bigjosh/Mechanical/README.md

# Mechanical
Mechanical design files

This repo contains documentation for the mechanical components & assembly of The Public Radio.
