bigjosh/Mechanical/PR2034 Antenna.stp

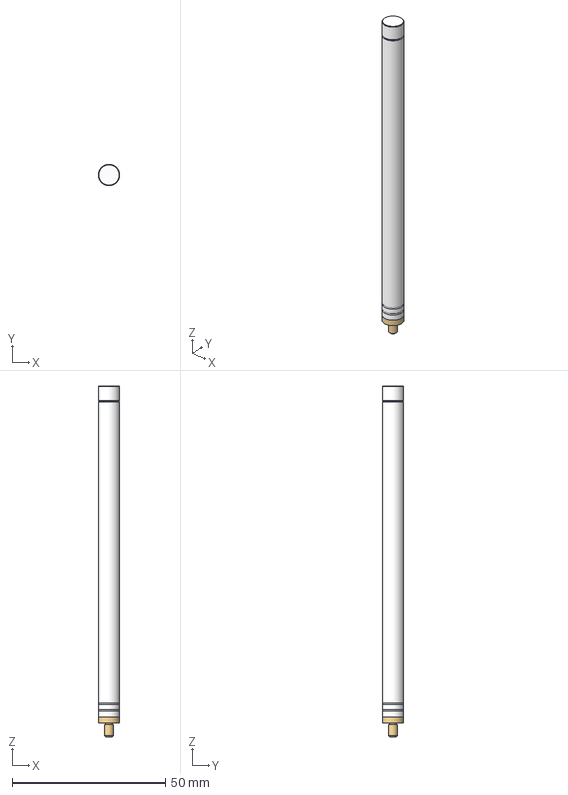
[picture p1: CAD file, 2017-05-16]
PR2034 Antenna.stp
6.99 x 7.00 x 114.5 mm
PR1029 Male thread antenna base
PR1030 Antenna tube 1
PR1031 Antenna tube 2
PR1032 Antenna tube 3
PR1033 Antenna tube 4
PR1034 Antenna tube 5
PR1035 Antenna tube 6
PR1036 Antenna cap
