bigjosh/Mechanical/PR2033 Ground up speaker.stp

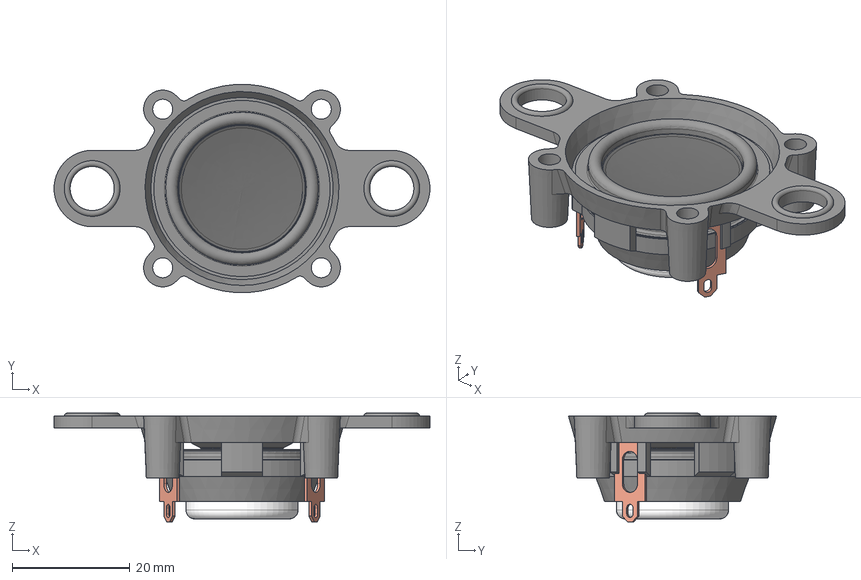
[picture p2: CAD file, 2016-03-14]
PR2033 Ground up speaker.stp
64.0 x 35.4 x 18.5 mm
PR2029 Redesigned speaker basket
YP
UT
CT
HS
FC
YQ
TB
PRT0003
PR2033 Speaker terminal x 2
