bigjosh/Mechanical/PR1014 REV H Sheet lid.stp

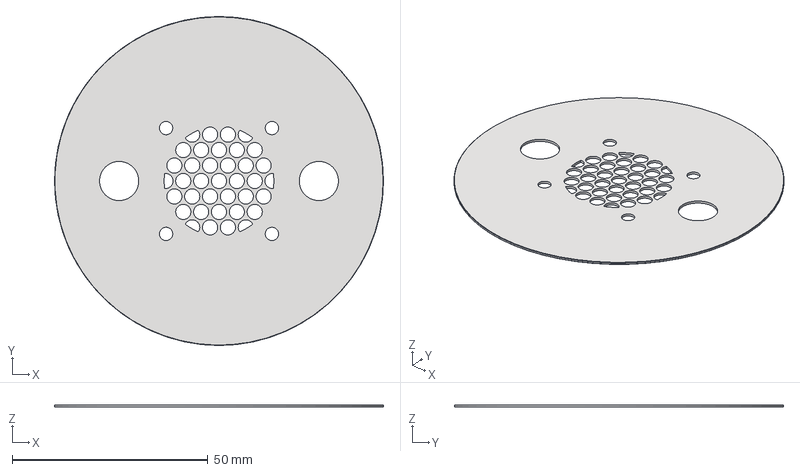
[picture p3: CAD file, 2016-03-14]
PR1014 REV H Sheet lid.stp
84.0 x 84.0 x 0.607 mm
