bigjosh/Mechanical/PR1037 Knob.stp

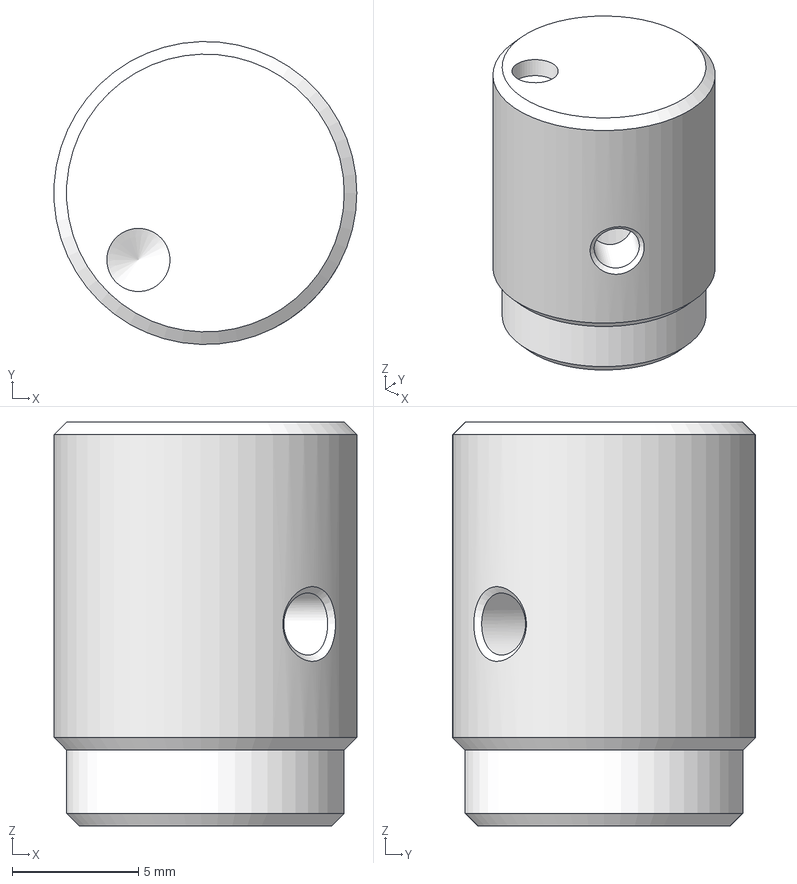
[picture p4: CAD file, 2016-03-14]
PR1037 Knob.stp
12.0 x 12.0 x 16.0 mm
