bigjosh/Mechanical/PR2034 Antenna REV A.pdf

## PART LIST

## REVISIONS

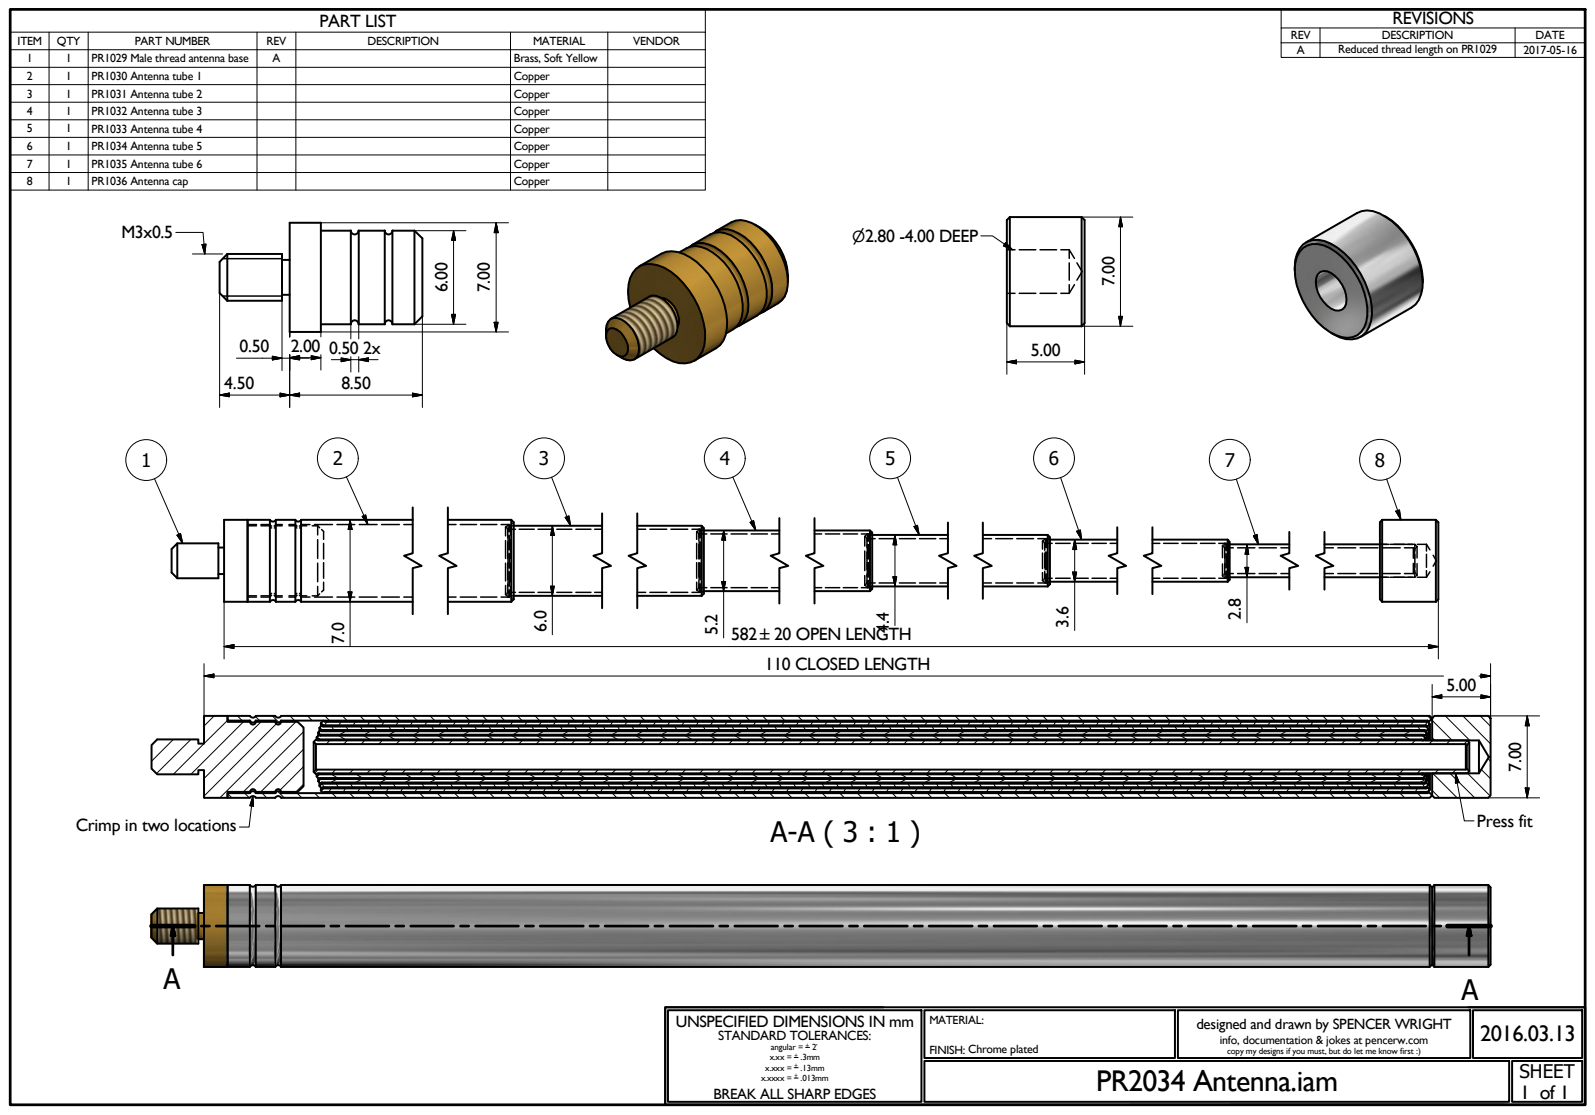
[picture p5: page 1]
ITEM; QTY; PART NUMBER; REV; DESCRIPTION; MATERIAL; VENDOR; PR1029 Male thread antenna base; Brass, Soft Yellow; PR1030 Antenna tube 1; Copper; PR1031 Antenna tube 2; PR1032 Antenna tube 3; PR1033 Antenna tube 4; PR1034 Antenna tube 5; PR1035 Antenna tube 6; PR1036 Antenna cap; PR2034 Antenna.iam; SHEET; STANDARD TOLERANCES:; angular =; x.xxx =; x.xxxx =; MATERIAL:; DATE; Reduced thread length on PR1029; 110 CLOSED LENGTH; 582 B20 OPEN LENGTH; P2.80 -4.00 DEEP; Press fit

Crimp in two locations

UNSPECIFIED DIMENSIONS IN mm

designed and drawn by SPENCER WRIGHT
info, documentation & jokes at pencerw.com
copy my designs if you must, but do let me know first :)

FINISH: Chrome plated

BREAK ALL SHARP EDGES
