bigjosh/Mechanical/PR2038 Public Radio Two REV A.pdf

## REVISIONS

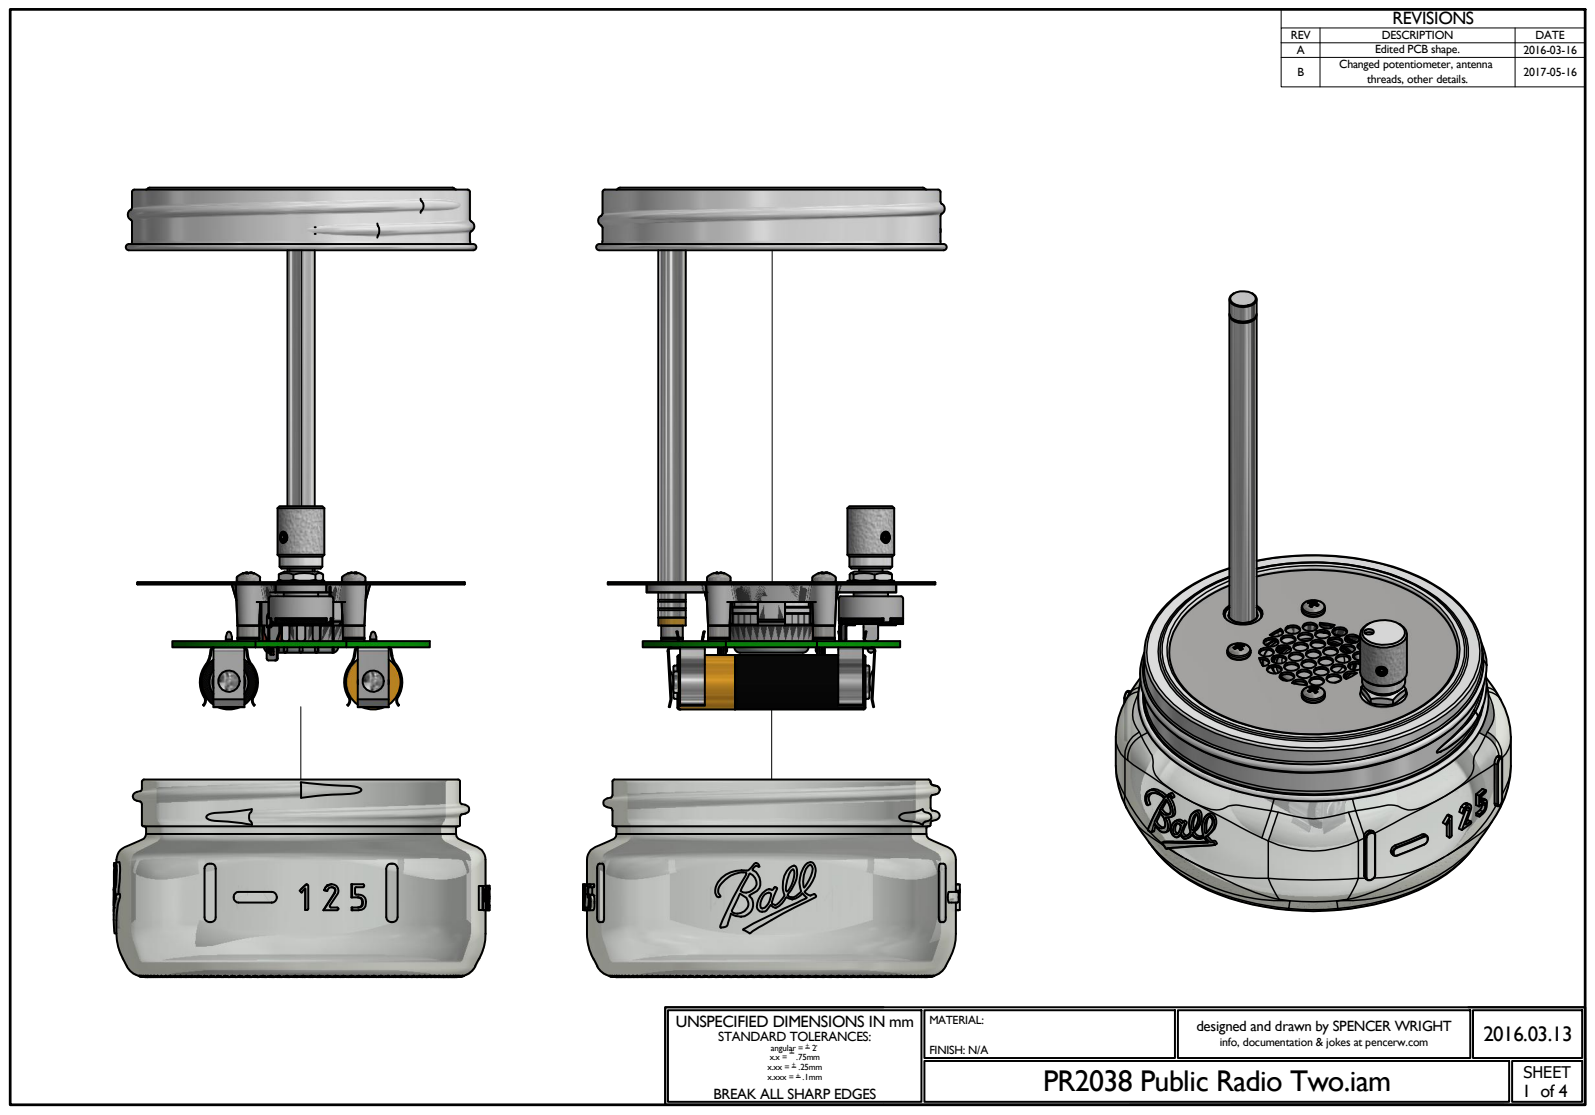
[picture p6: page 1]
SHEET; STANDARD TOLERANCES:; angular = x.x =; x.xx = x.xxx =; MATERIAL:; FINISH: N/A; REV; DESCRIPTION; DATE; Edited PCB shape.

Changed potentiometer, antenna
threads, other details.

UNSPECIFIED DIMENSIONS IN mm

designed and drawn by SPENCER WRIGHT
info, documentation & jokes at pencerw.com

PR2038 Public Radio Two.iam

BREAK ALL SHARP EDGES

## PART LIST

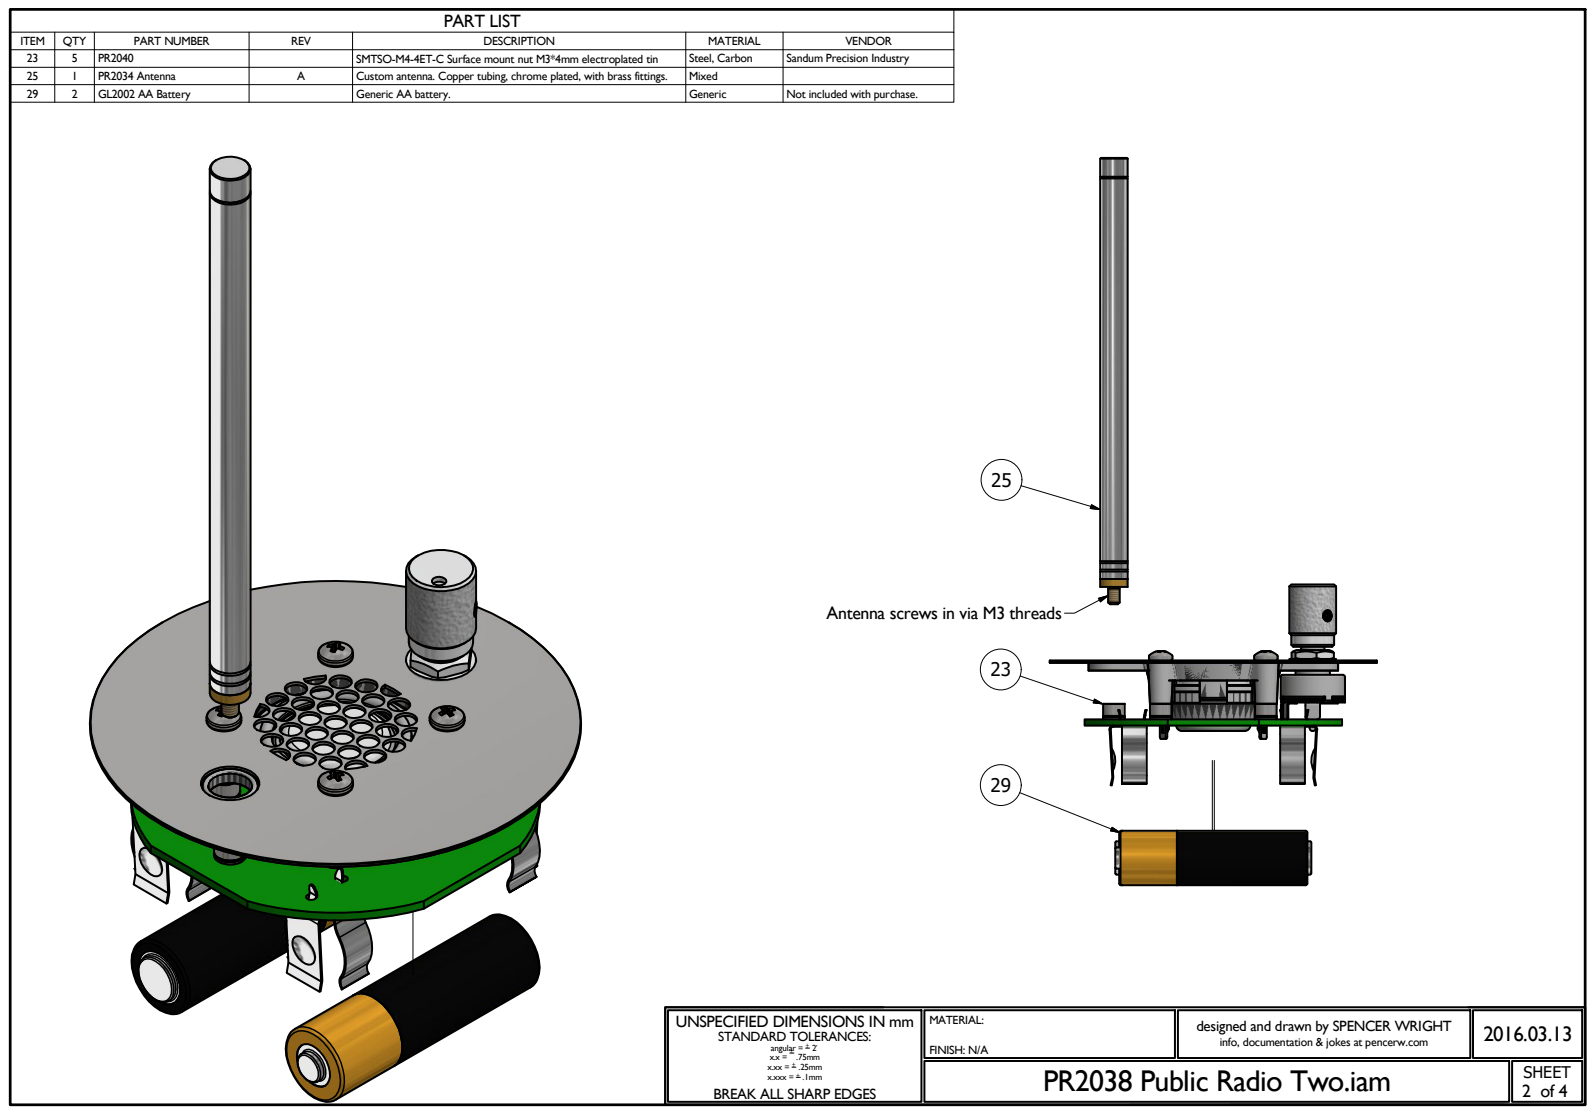
[picture p7: page 2]
ITEM; QTY; PART NUMBER; REV; DESCRIPTION; MATERIAL; VENDOR; SMTSO-M4-4ET-C Surface mount nut M3*4mm electroplated tin; Steel, Carbon; Sandum Precision Industry; PR2034 Antenna; Custom antenna. Copper tubing, chrome plated, with brass fittings.; Mixed; GL2002 AA Battery; Generic AA battery.; Generic; Not included with purchase.; STANDARD TOLERANCES:; MATERIAL:

Antenna screws in via M3 threads

UNSPECIFIED DIMENSIONS IN mm

designed and drawn by SPENCER WRIGHT

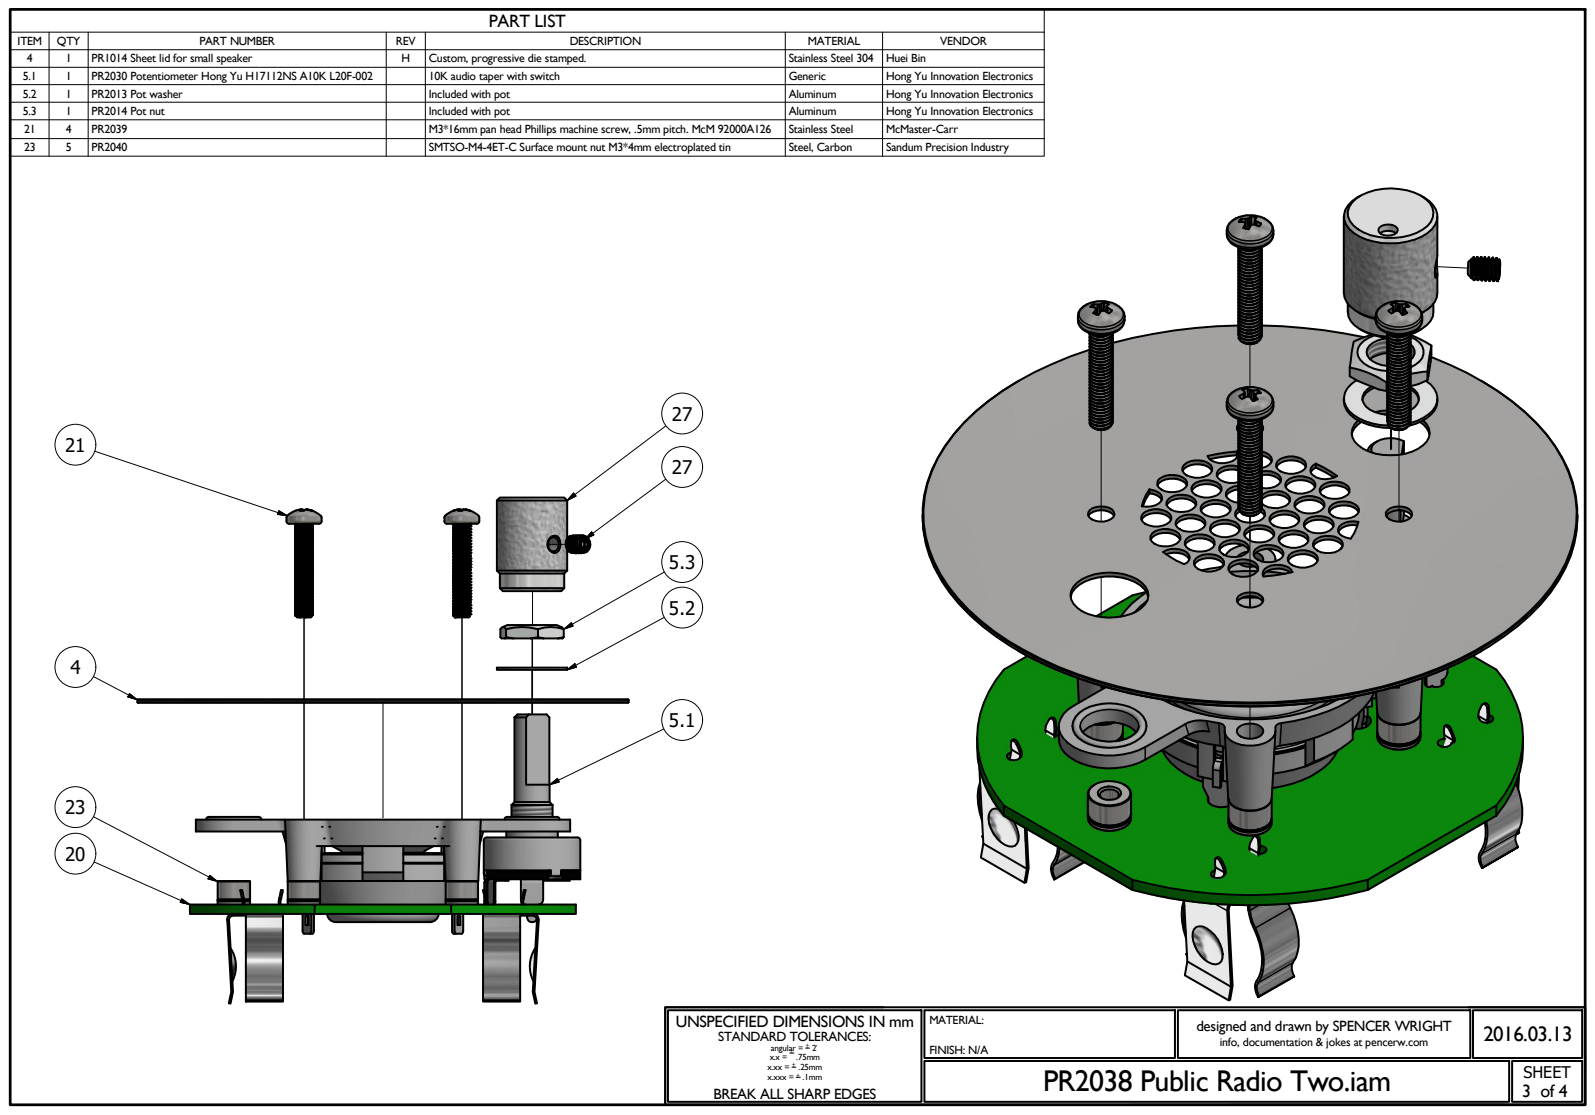
[picture p8: page 3]
PR1014 Sheet lid for small speaker; Custom, progressive die stamped.; Stainless Steel 304; Huei Bin; PR2030 Potentiometer Hong Yu H17112NS A10K L20F-002; 10K audio taper with switch; Generic; Hong Yu Innovation Electronics; PR2013 Pot washer; Included with pot; Aluminum; PR2014 Pot nut; M3*16mm pan head Phillips machine screw, .5mm pitch. McM 92000A126; Stainless Steel; McMaster-Carr; SMTSO-M4-4ET-C Surface mount nut M3*4mm electroplated tin; Steel, Carbon; Sandum Precision Industry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

UNSPECIFIED DIMENSIONS IN mm

designed and drawn by SPENCER WRIGHT

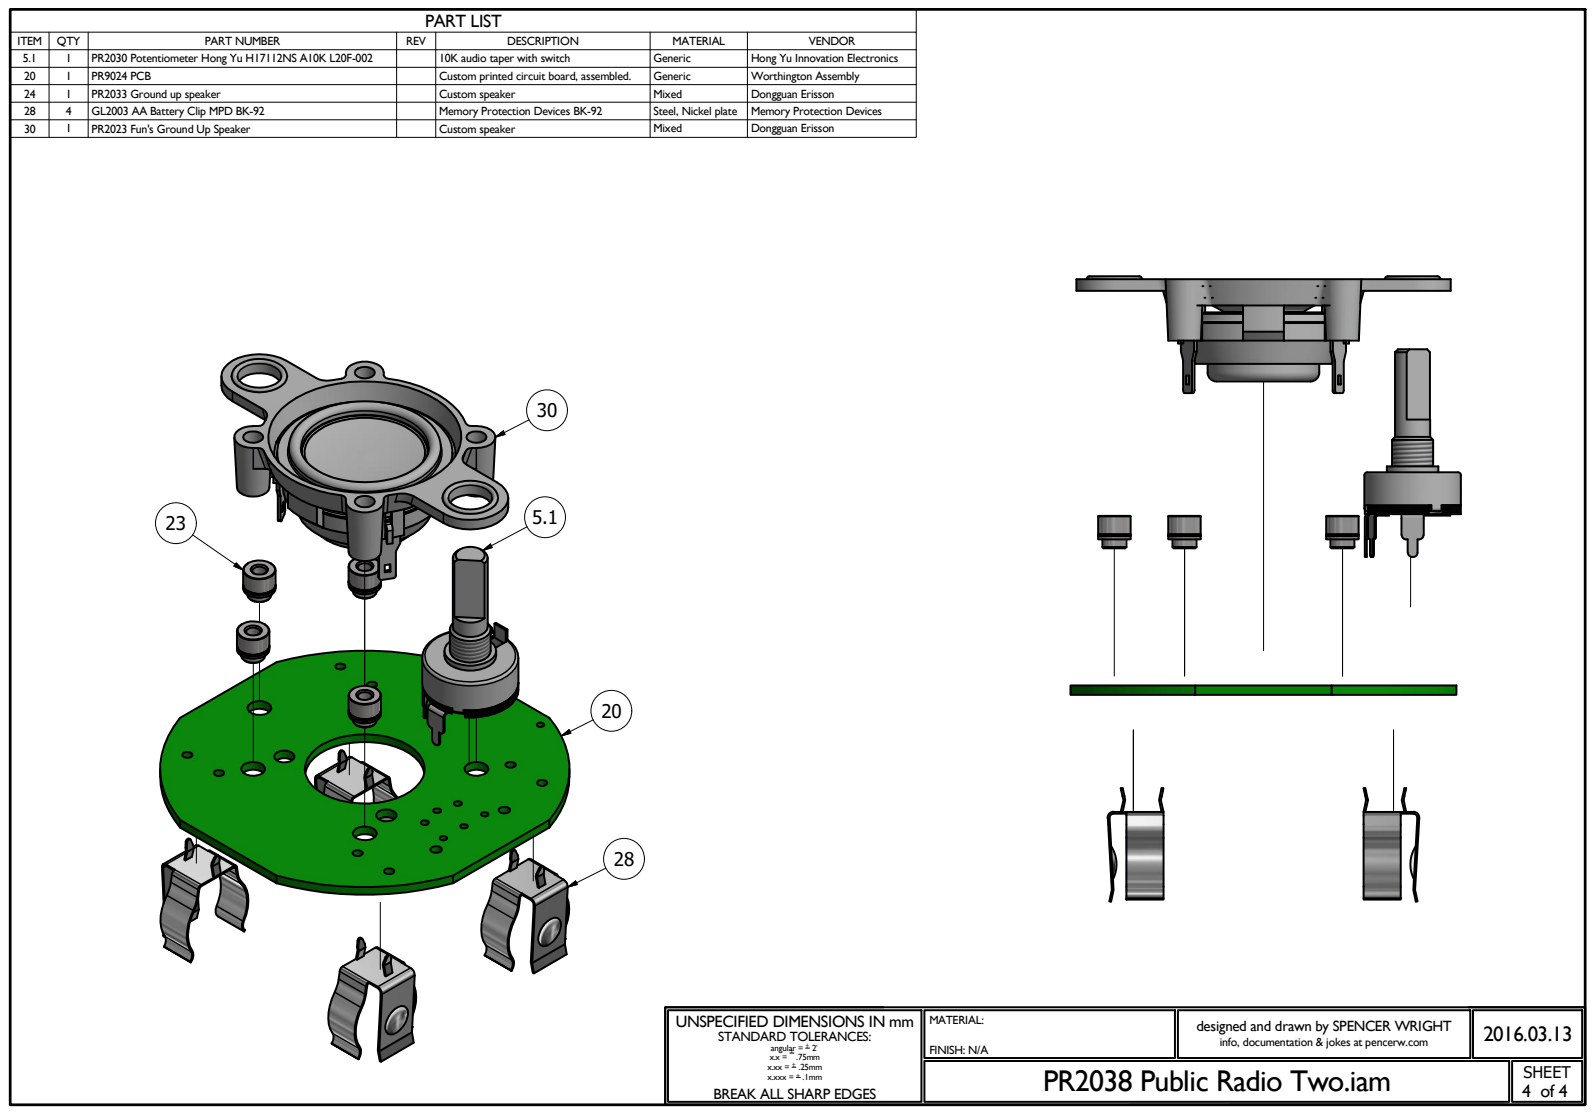
[picture p9: page 4]
PR2030 Potentiometer Hong Yu H17112NS A10K L20F-002; 10K audio taper with switch; Generic; Hong Yu Innovation Electronics; PR9024 PCB; Custom printed circuit board, assembled.; Worthington Assembly; PR2033 Ground up speaker; Custom speaker; Mixed; Dongguan Erisson; GL2003 AA Battery Clip MPD BK-92; Memory Protection Devices BK-92; Steel, Nickel plate; Memory Protection Devices; PR2023 Fun's Ground Up Speaker; STANDARD TOLERANCES:; MATERIAL:

UNSPECIFIED DIMENSIONS IN mm

designed and drawn by SPENCER WRIGHT
