bigjosh/Mechanical/PR2033 Ground up speaker.pdf

## PART LIST

## REVISIONS

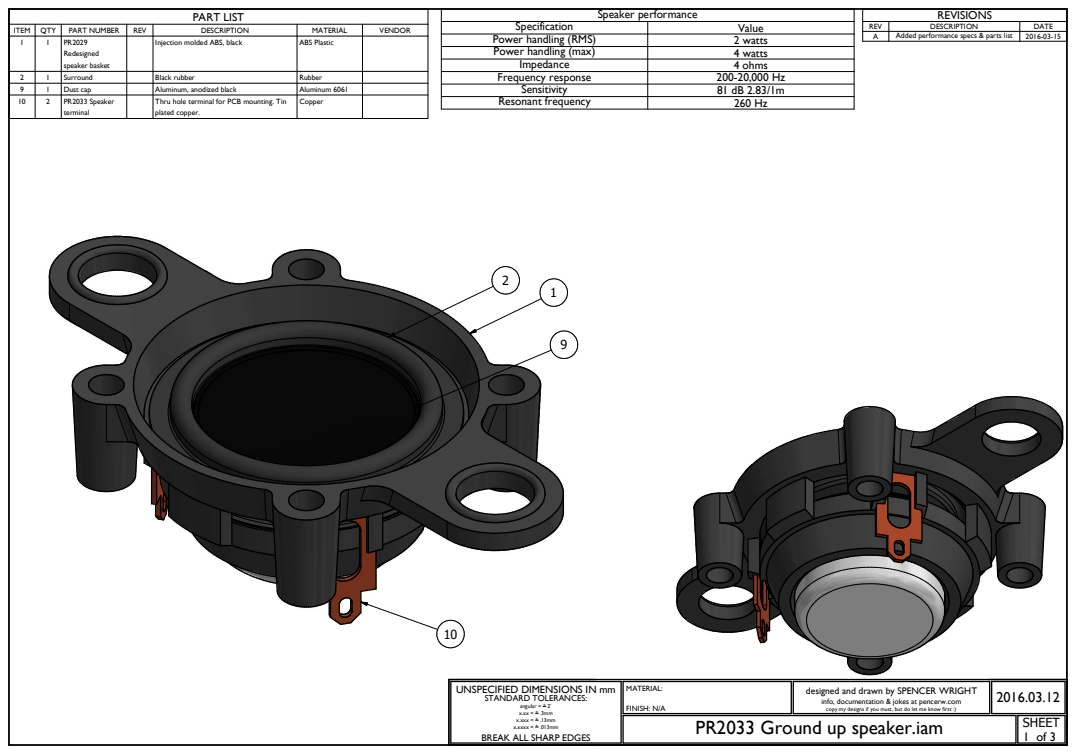
[picture p10: page 1]
2016.03.12 SHEET 1 of 3; MATERIAL: FINISH: N/A; ITEM QTY PART NUMBER REV; DESCRIPTION; MATERIAL; VENDOR; Injection molded ABS, black; ABS Plastic; Redesigned speaker basket; 1 Surround; Black rubber; Rubber; 1 Dust cap; Aluminum, anodized black; Aluminum 6061; PR2033 Speaker terminal; REV; DATE; Speaker performance; Specification; Value; Power handling (RMS); 2 watts; Power handling (max); 4 watts; Impedance; 4 ohms; Frequency response; Sensitivity; Resonant frequency

A Added performance specs & parts list 2016-03-15

Thru hole terminal for PCB mounting. Tin Copper
plated copper.

UNSPECIFIED DIMENSIONS IN mm
STANDARD TOLERANCES:
angular = ⁺- 2~
x.xxx = ⁺- .13mm
x.xxxx = ⁺- .013mm
BREAK ALL SHARP EDGES

designed and drawn by SPENCER WRIGHT
info, documentation & jokes at pencerw.com
PR2033 Ground up speaker.iam

copy my designs if you must, but do let me know first :)

# n3.4 THRU 4x 13 5. 13.5 2 5. 12.5

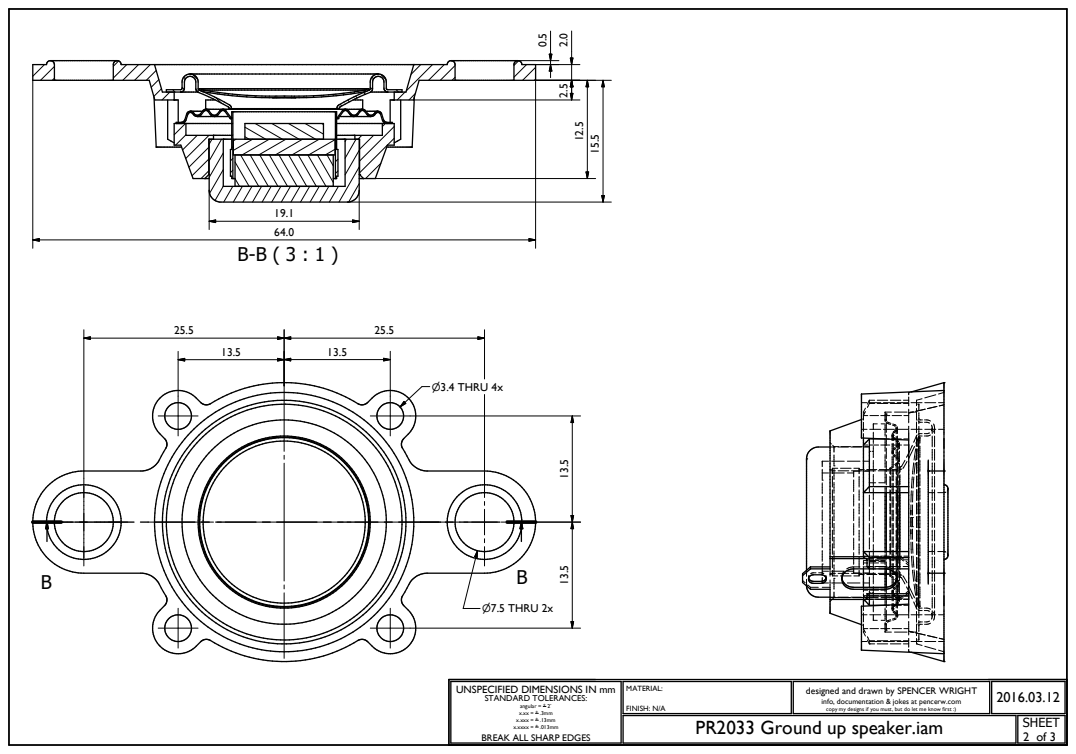
[picture p11: page 2]
MATERIAL:; n7.5 THRU 2x

UNSPECIFIED DIMENSIONS IN mm
STANDARD TOLERANCES:

designed and drawn by SPENCER WRIGHT
info, documentation & jokes at pencerw.com

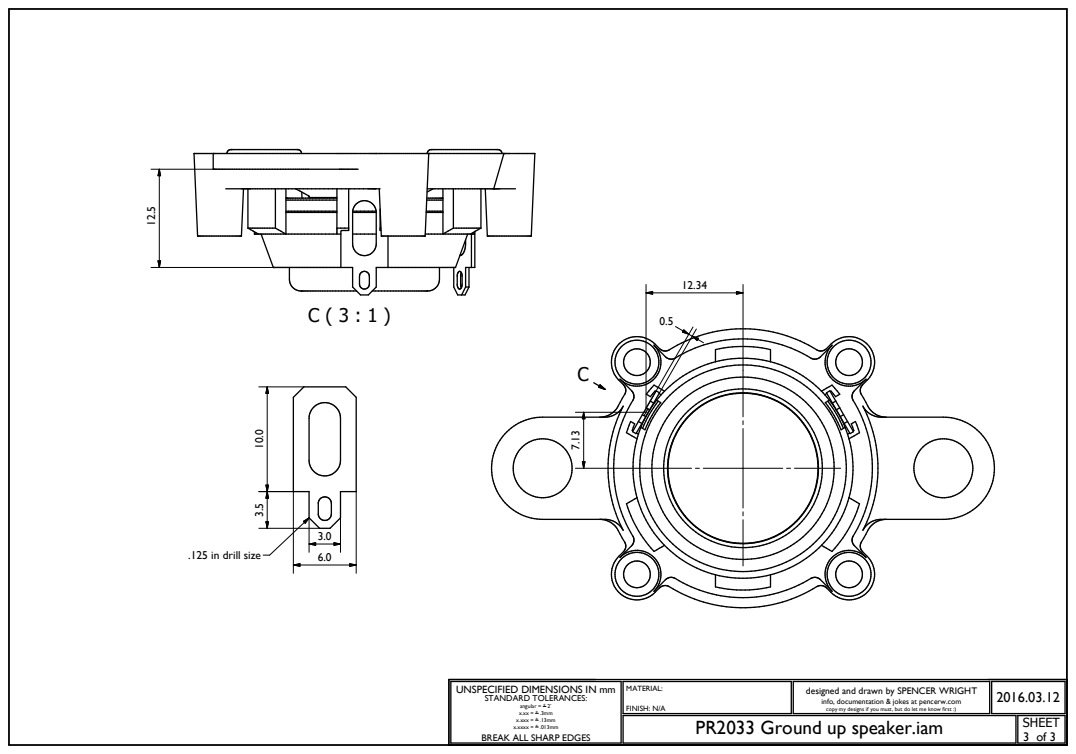
[picture p12: page 3]
.125 in drill size

UNSPECIFIED DIMENSIONS IN mm STANDARD TOLERANCES: | MATERIAL: | designed and drawn by SPENCER WRIGHT info, documentation & jokes at pencerw.com | 2016.03.12
