bigjosh/Mechanical/PR2036 Knob assy.pdf

## PART LIST

## REVISIONS

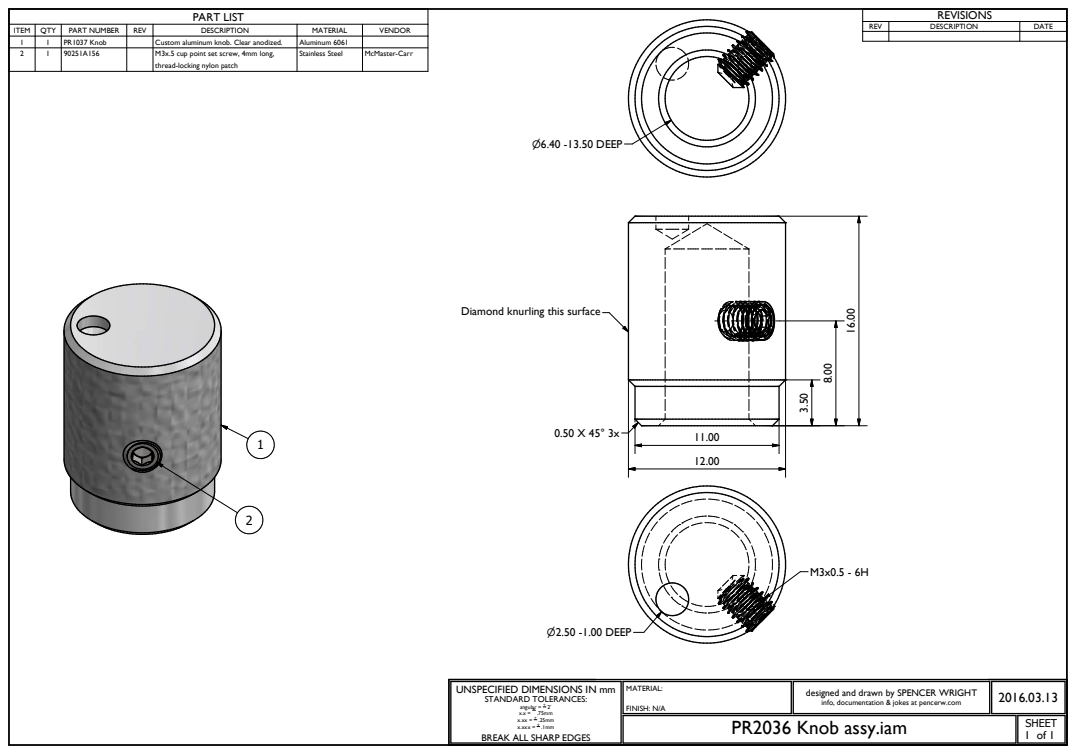
[picture p13: page 1]
2016.03.13 SHEET 1 of 1; ITEM QTY PART NUMBER REV; DESCRIPTION; MATERIAL; VENDOR; 1 PR1037 Knob; Custom aluminum knob. Clear anodized. Aluminum 6061; M3x.5 cup point set screw, 4mm long,; Stainless Steel; McMaster-Carr; REV; DATE; n2.50 -1.00 DEEP; n6.40 -13.50 DEEP

thread-locking nylon patch

Diamond knurling this surface

UNSPECIFIED DIMENSIONS IN mm
STANDARD TOLERANCES:
angular = ⁺- 2~
x.xxx = ⁺- .1mm
BREAK ALL SHARP EDGES

MATERIAL:
FINISH: N/A
PR2036 Knob assy.iam

designed and drawn by SPENCER WRIGHT
info, documentation & jokes at pencerw.com
