bigjosh/Mechanical/PR1014 REV H Sheet lid.pdf

## REVISIONS

## 24ga STOCK

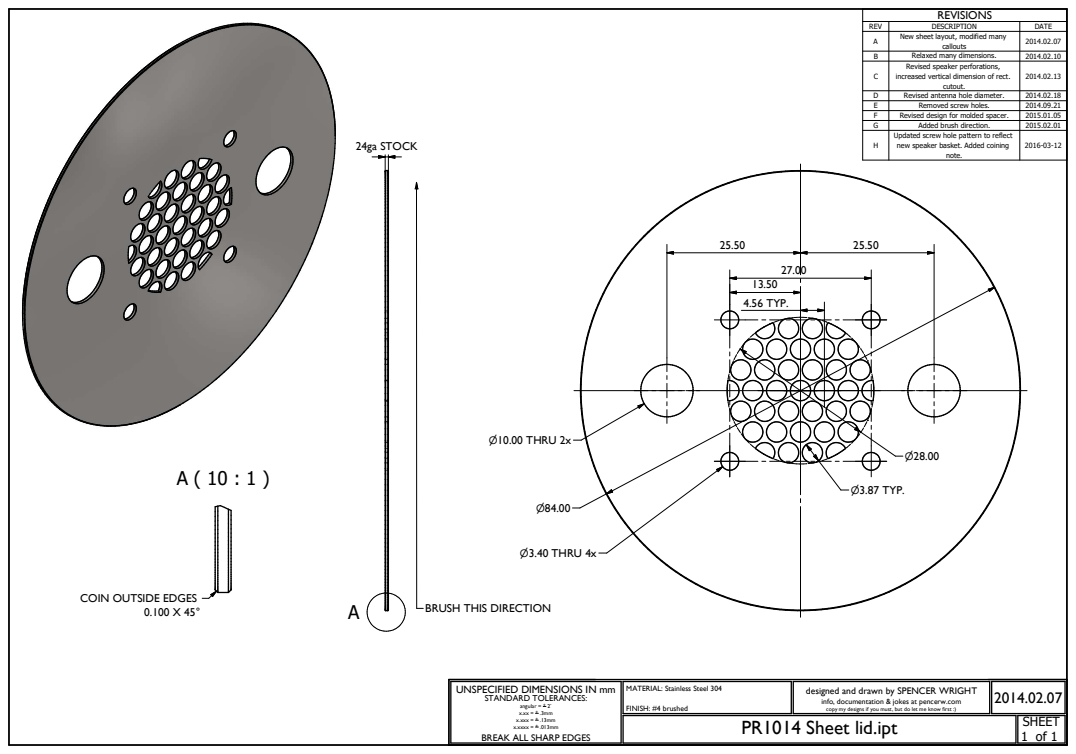
[picture p14: page 1]
2014.02.07 SHEET 1 of 1; REV; DESCRIPTION; DATE; callouts; Relaxed many dimensions.; Removed screw holes.; Added brush direction.; 4.56 TYP.; n3.87 TYP.; n10.00 THRU 2x; n3.40 THRU 4x

New sheet layout, modified many
Revised speaker perforations,
D Revised antenna hole diameter. 2014.02.18
F Revised design for molded spacer. 2015.01.05
Updated screw hole pattern to reflect
new speaker basket. Added coining
note.

increased vertical dimension of rect.
cutout.

COIN OUTSIDE EDGES

BRUSH THIS DIRECTION

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

MATERIAL: Stainless Steel 304
FINISH: #4 brushed

designed and drawn by SPENCER WRIGHT
info, documentation & jokes at pencerw.com
PR1014 Sheet lid.ipt

copy my designs if you must, but do let me know first :)
