bigjosh/Mechanical/(commit log)

2016-03-13 Added drawings
    for lid, knob, speaker, and antenna
2016-03-14 updated drawings, added STEPs
    these are pretty good.
    [PR1014 REV H Sheet lid.stp, PR1037 Knob.stp, PR2033 Ground up speaker.stp, PR2034 Antenna.stp]
2016-03-19 Updated PCB shape
    this affects only the full assembly drawing
2017-05-16 V2 updates
    Updated antenna thread length; updated potentiometer design; updated
    vendors on PDF; other minor changes.
    [PR2034 Antenna.stp]
